Eih3/Projet-RAGT-2015/Documents/PCB/Images/BDE54ddd67690729_03.jpg

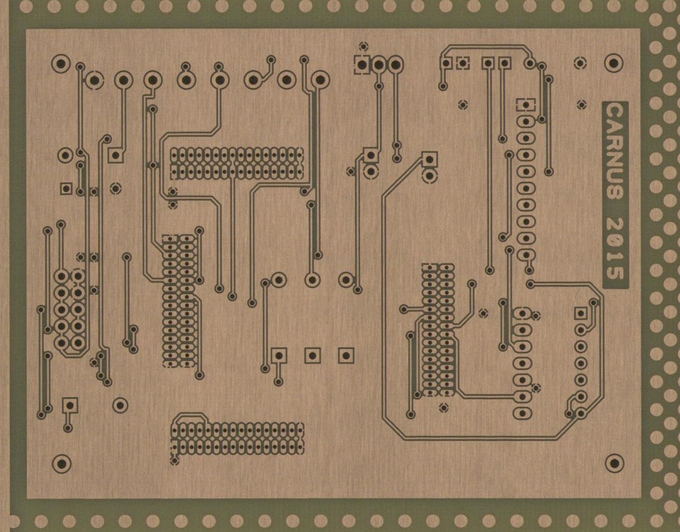
Documents/PCB/Images/BDE54ddd67690729_03.jpg
