Eih3/Projet-RAGT-2015/README.md

# Projet-RAGT-2015
Codes source de la programmation de la carte HF et de la Télécommande
