Eih3/Projet-RAGT-2015/Programmation/Module HF/Module HF.cydsn/CortexM3/ARM_GCC_484/Release/LINK_options.txt

-Wl,--start-group -o ".\\CortexM3\\ARM_GCC_484\\Release\\Module\ HF.elf" ".\\CortexM3\\ARM_GCC_484\\Release\\main.o" ".\\CortexM3\\ARM_GCC_484\\Release\\EEPROM.o" ".\\CortexM3\\ARM_GCC_484\\Release\\Application.o" ".\\CortexM3\\ARM_GCC_484\\Release\\WIFI.o" ".\\CortexM3\\ARM_GCC_484\\Release\\Interruptions.o" ".\\CortexM3\\ARM_GCC_484\\Release\\cymetadata.o" ".\\CortexM3\\ARM_GCC_484\\Release\\Cm3Start.o" ".\\CortexM3\\ARM_GCC_484\\Release\\Module\ HF.a" "C:\\Program\ Files\ (x86)\\Cypress\\PSoC\ Creator\\3.1\\PSoC\ Creator\\psoc\\content\\cycomponentlibrary\\CyComponentLibrary.cylib\\CortexM3\\ARM_GCC_484\\Release\\CyComponentLibrary.a" -mthumb -march=armv7-m -mfix-cortex-m3-ldrd "-Wl,-Map,.\\CortexM3\\ARM_GCC_484\\Release/Module\ HF.map" -T ".\\Generated_Source\\PSoC5\\cm3gcc.ld" -g -specs=nano.specs "-u\ _printf_float"  -Wl,--gc-sections -Wl,--end-group
