Eih3/Projet-RAGT-2015/Documents/PCB/Carte Autom.png

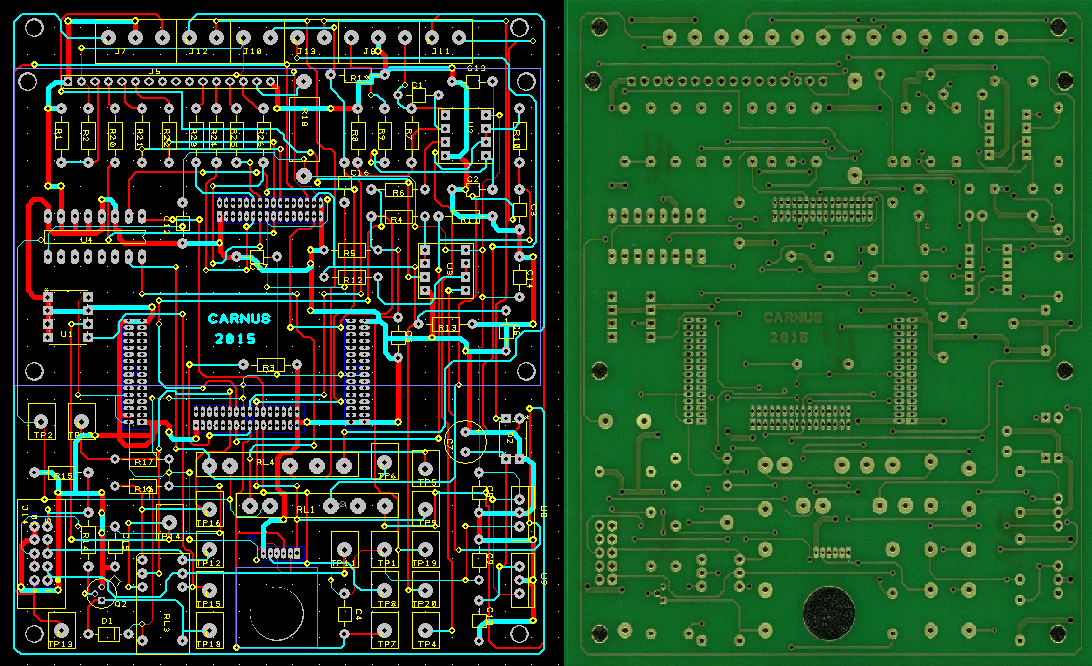
Documents/PCB/Carte Autom.png
