Eih3/Projet-RAGT-2015/Documents/PCB/Images/BDE54ddd677cd2a8_02.jpg

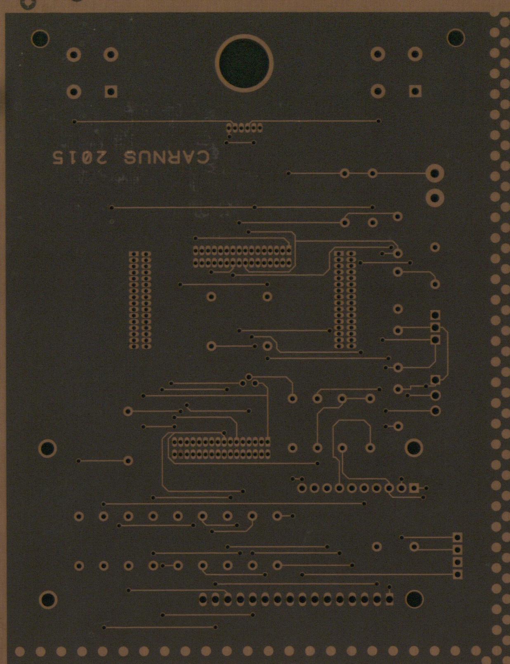
Documents/PCB/Images/BDE54ddd677cd2a8_02.jpg
