Eih3/Projet-RAGT-2015/Documents/PCB/Images/BDE54ddd677cd2a8_03_bottom.jpg

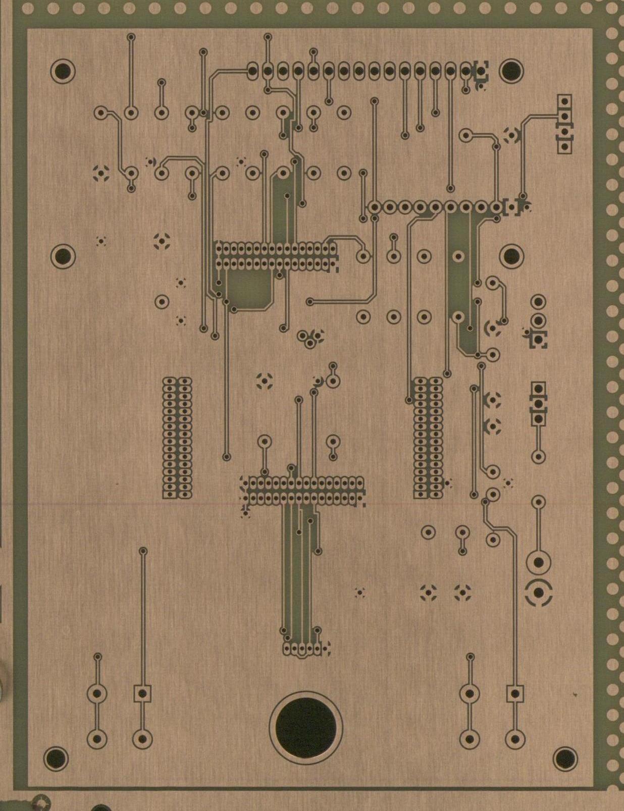
Documents/PCB/Images/BDE54ddd677cd2a8_03_bottom.jpg
