Eih3/Projet-RAGT-2015/Documents/PCB/Images/BDE54ddd6755764d_02.jpg

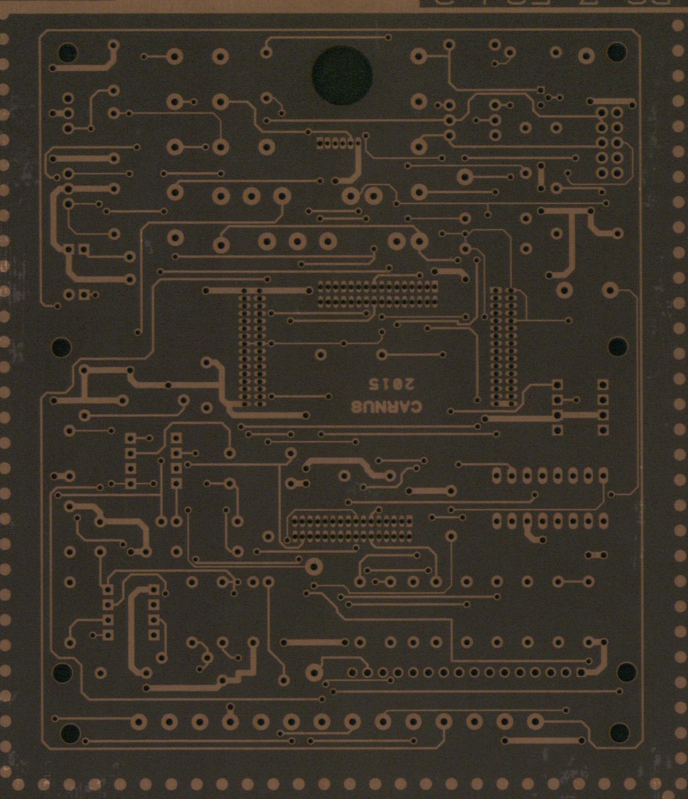
Documents/PCB/Images/BDE54ddd6755764d_02.jpg
