Eih3/Projet-RAGT-2015/Documents/PCB/Images/BDE54ddd6755764d_02_bottom.jpg

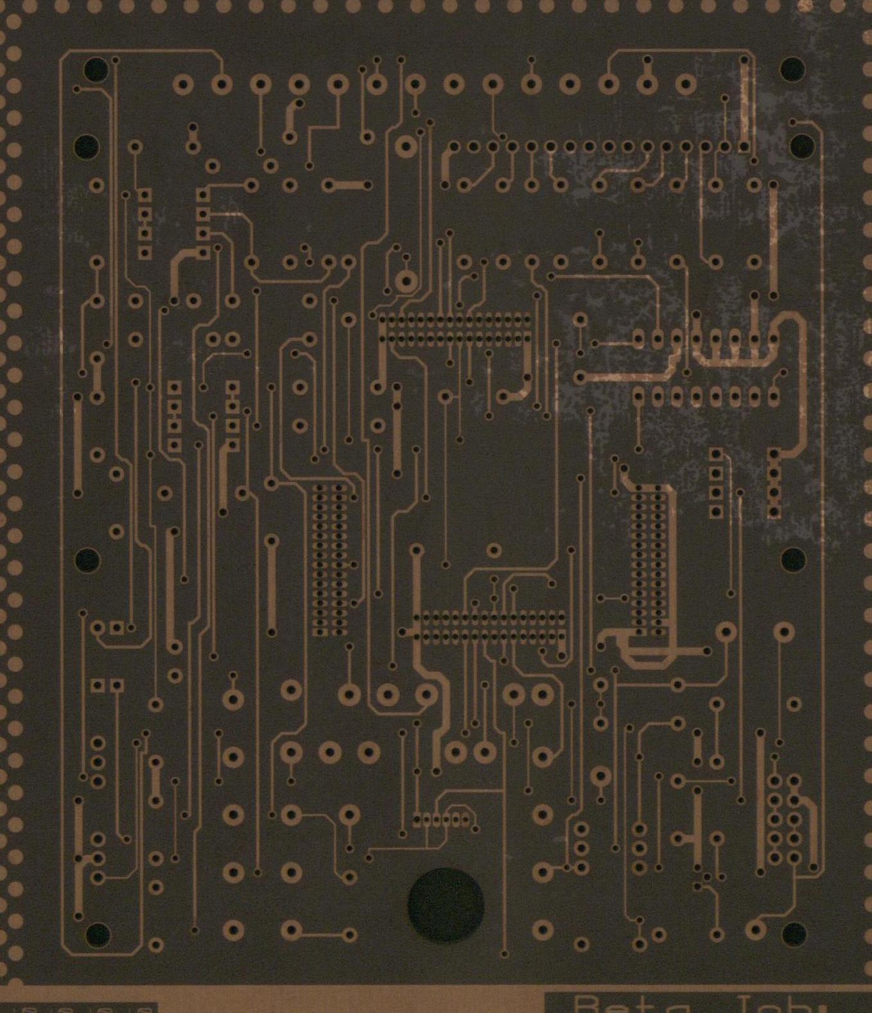
Documents/PCB/Images/BDE54ddd6755764d_02_bottom.jpg
