Eih3/Projet-RAGT-2015/Documents/PCB/Images/BDE54ddd67690729_04_seite1.jpg

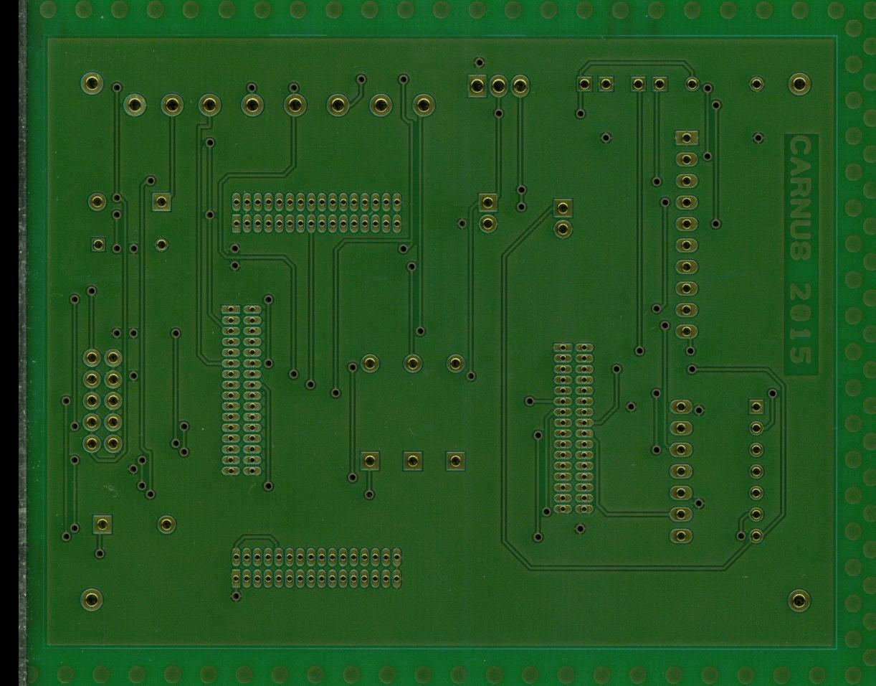
Documents/PCB/Images/BDE54ddd67690729_04_seite1.jpg
