Eih3/Projet-RAGT-2015/Documents/USR-WIFI232-T/5.JPG

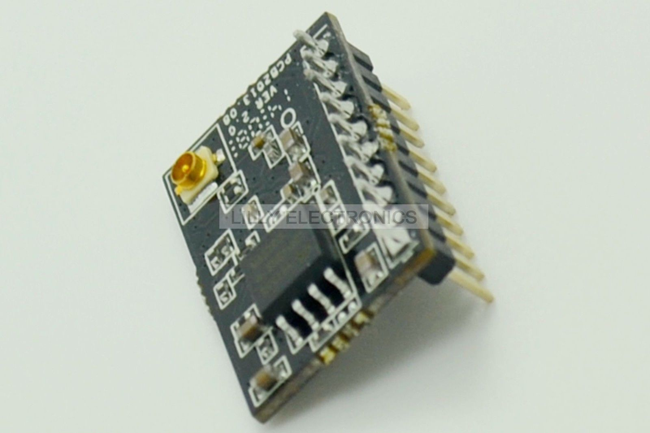
Documents/USR-WIFI232-T/5.JPG
