Eih3/Projet-RAGT-2015/Documents/USR-WIFI232-T/USR-WIFI232-T-size.png

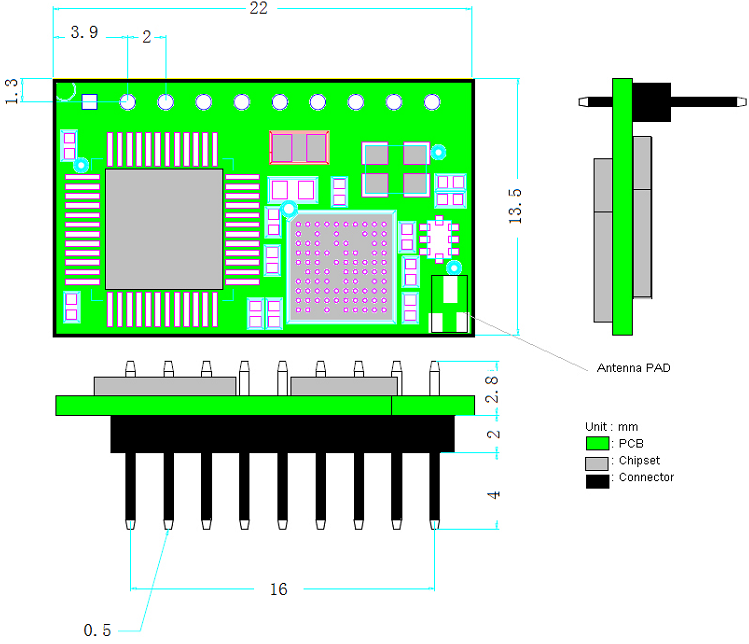
Documents/USR-WIFI232-T/USR-WIFI232-T-size.png
