Eih3/Projet-RAGT-2015/Programmation/Module HF/Module HF.cydsn/CortexM3/ARM_GCC_484/Debug/LINK_options.txt

-Wl,--start-group -o ".\\CortexM3\\ARM_GCC_484\\Debug\\Carte\ HF.elf" ".\\CortexM3\\ARM_GCC_484\\Debug\\main.o" ".\\CortexM3\\ARM_GCC_484\\Debug\\EEPROM.o" ".\\CortexM3\\ARM_GCC_484\\Debug\\module_hf.o" ".\\CortexM3\\ARM_GCC_484\\Debug\\cymetadata.o" ".\\CortexM3\\ARM_GCC_484\\Debug\\Cm3Start.o" ".\\CortexM3\\ARM_GCC_484\\Debug\\Carte\ HF.a" "C:\\Program\ Files\ (x86)\\Cypress\\PSoC\ Creator\\3.1\\PSoC\ Creator\\psoc\\content\\cycomponentlibrary\\CyComponentLibrary.cylib\\CortexM3\\ARM_GCC_484\\Debug\\CyComponentLibrary.a" -mthumb -march=armv7-m -mfix-cortex-m3-ldrd "-Wl,-Map,.\\CortexM3\\ARM_GCC_484\\Debug/Carte\ HF.map" -T ".\\Generated_Source\\PSoC5\\cm3gcc.ld" -g -specs=nano.specs "-u\ _printf_float"  -Wl,--gc-sections -Wl,--end-group
