Eih3/Projet-RAGT-2015/Documents/PSoC5/CY8CKIT-010_Schematic.pdf

Storage Capacitors | Bypass Capacitors

## CY8C55 FAMILY

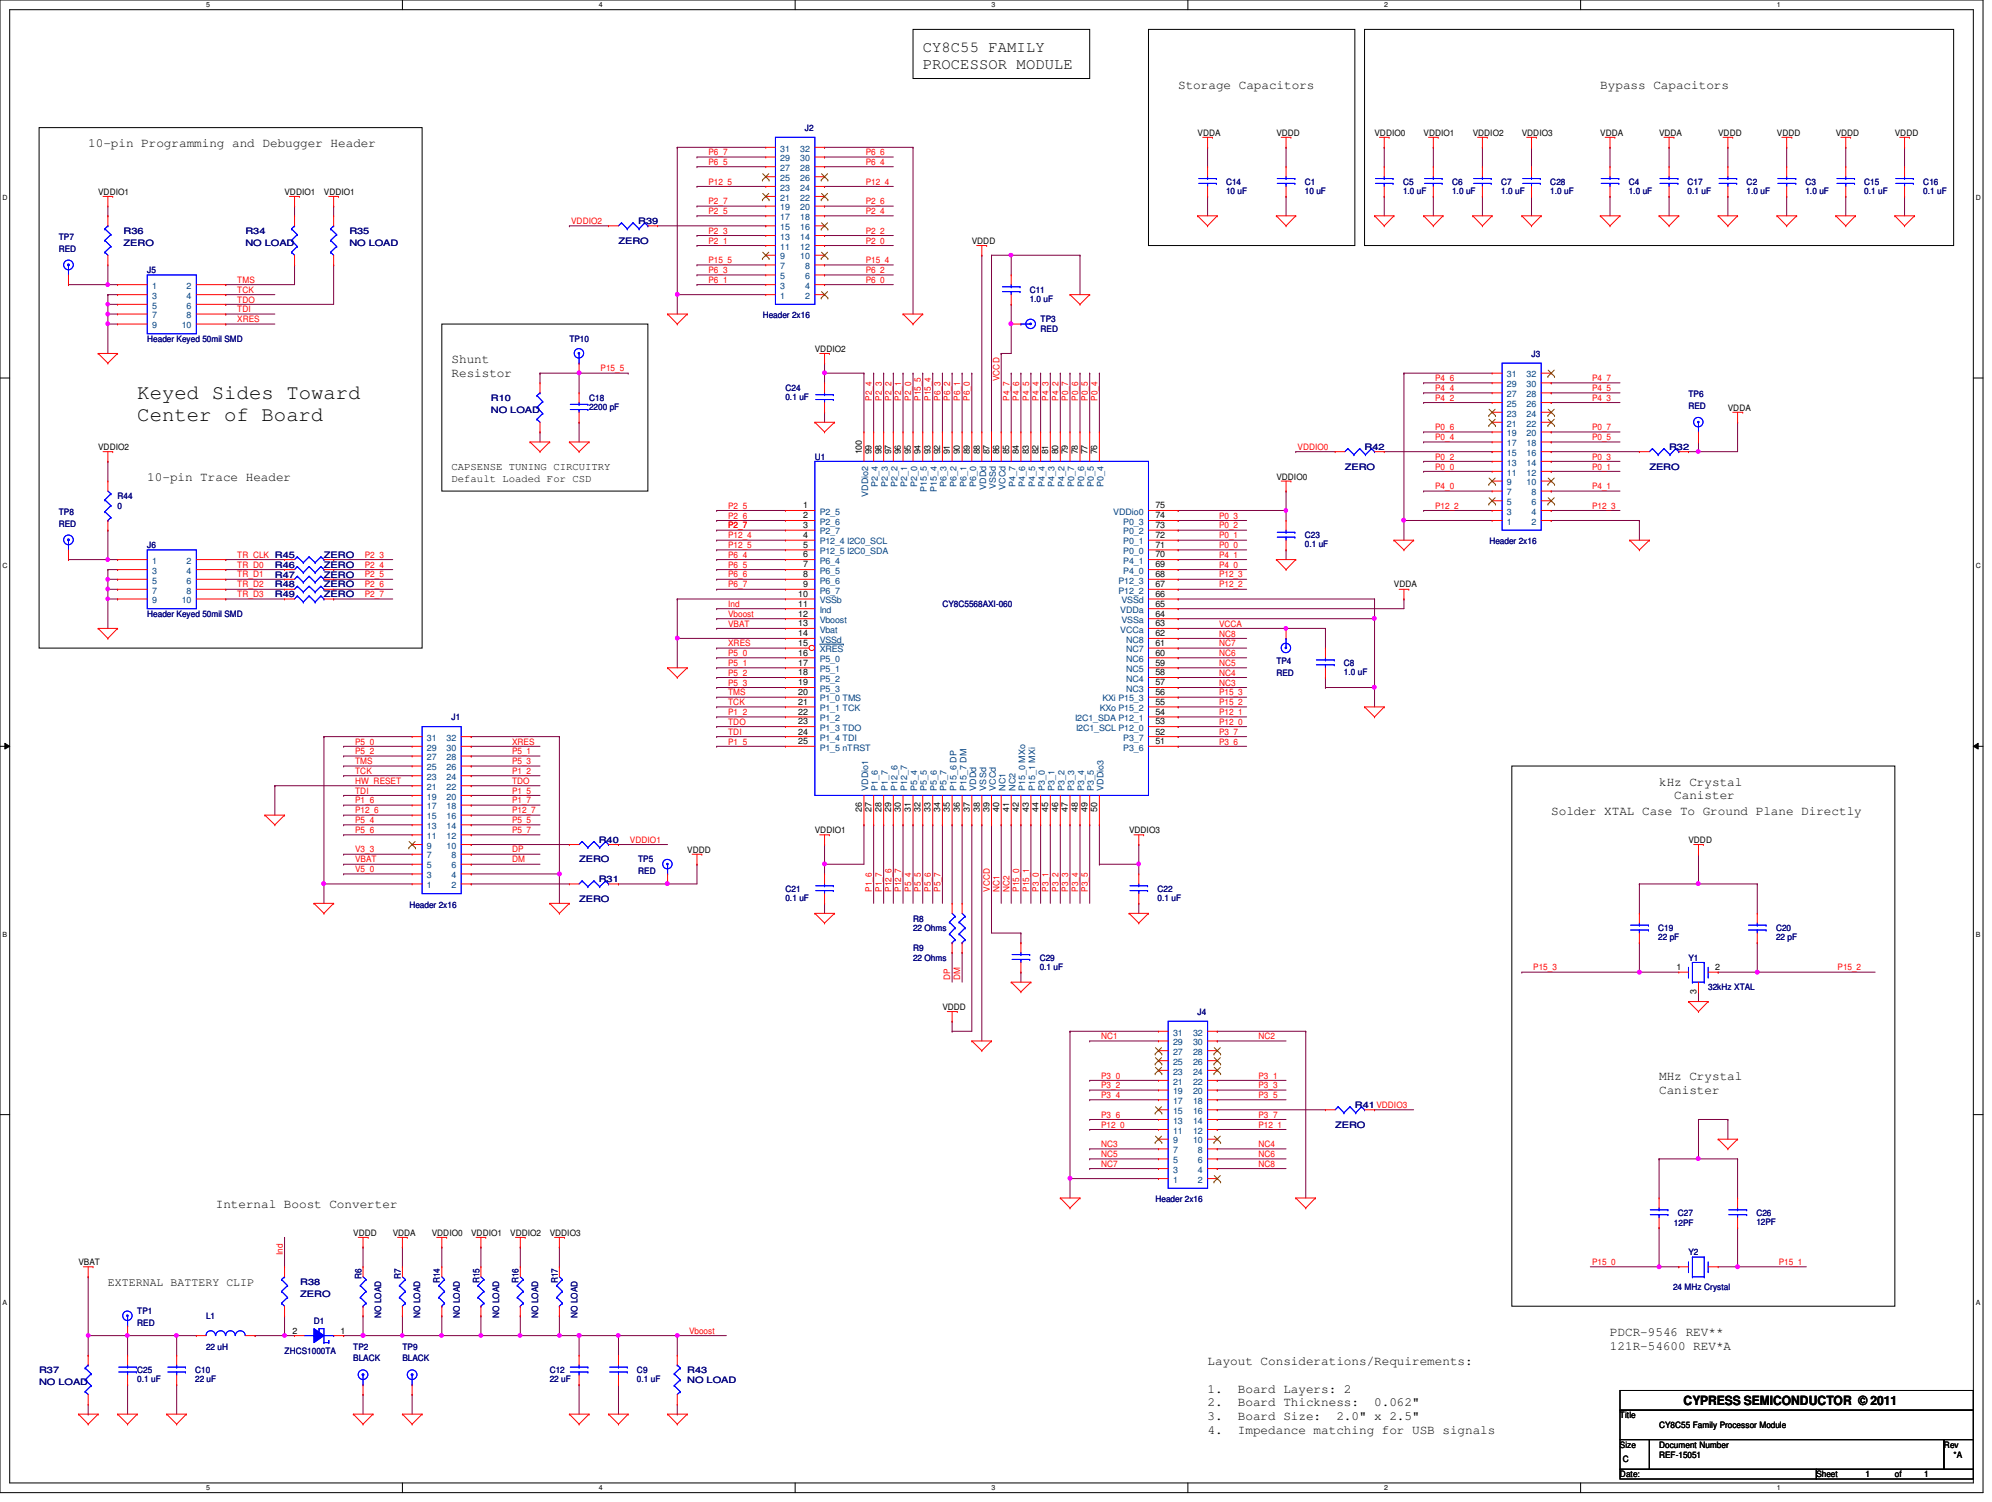
[picture p57: page 1]

10-pin Programming and Debugger Header

Solder XTAL Case To Ground Plane Directly

1. Board Layers: 2
4. Impedance matching for USB signals
