Eih3/Projet-RAGT-2015/Documents/PSoC5/PSOC Break out - Schematic.pdf

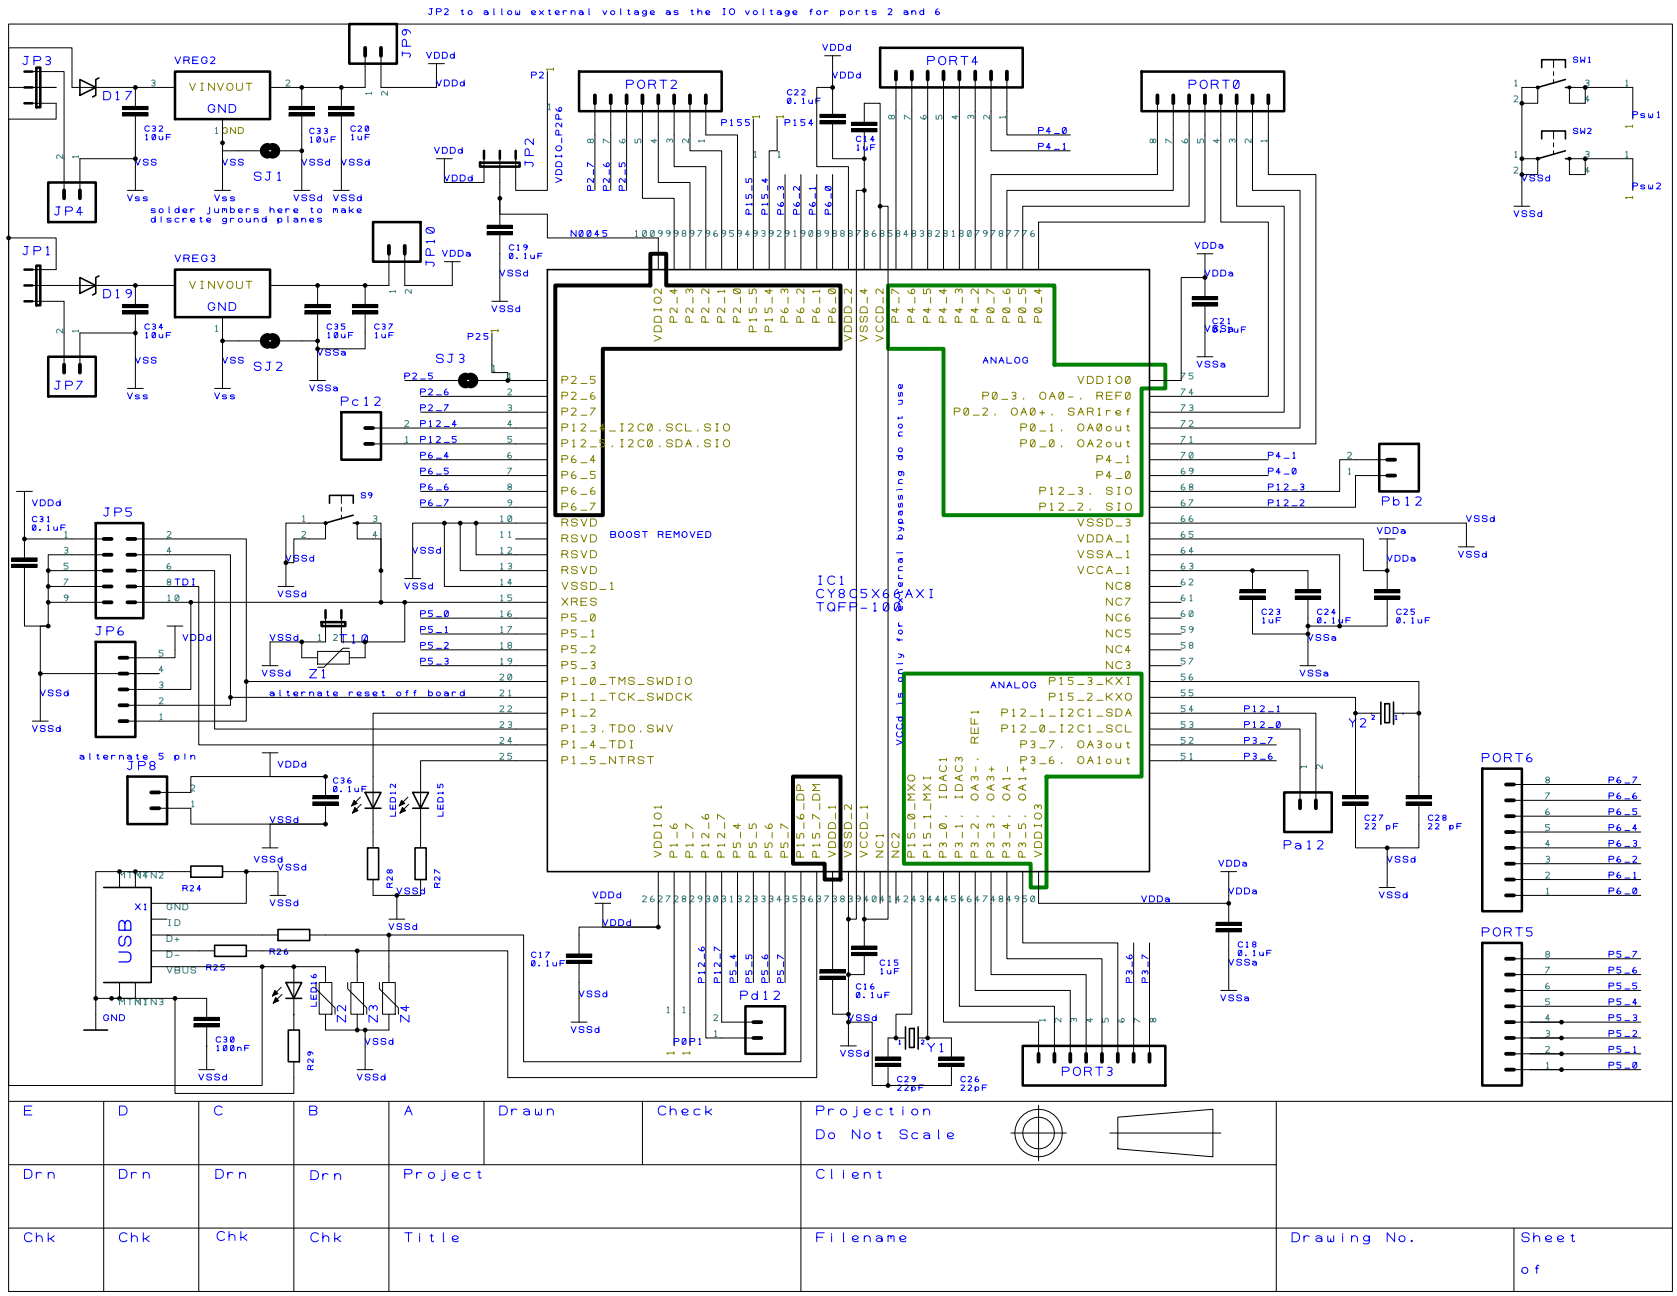
[picture p58: page 1]
