Eih3/Projet-RAGT-2015/(list of files, drawings)

Other design files:
Documents/DesignSpark/Afficheur.pcb
Documents/DesignSpark/PCB_autom.pcb
Documents/DesignSpark/Projet HF, Routage.pcb
Documents/PCB/Afficheur.pcb
Documents/PCB/HF.pcb
Documents/PCB/PCB_autom.pcb
