Eih3/Projet-RAGT-2015/Programmation/Module HF/Module HF.cydsn/codegentemp/UART_INT.c

/*******************************************************************************
* File Name: UARTINT.c
* Version 2.40
*
* Description:
*  This file provides all Interrupt Service functionality of the UART component
*
* Note:
*
********************************************************************************
* Copyright 2008-2015, Cypress Semiconductor Corporation.  All rights reserved.
* You may use this file only in accordance with the license, terms, conditions,
* disclaimers, and limitations in the end user license agreement accompanying
* the software package with which this file was provided.
*******************************************************************************/

#include "UART.h"


/***************************************
* Custom Declarations
***************************************/
/* `#START CUSTOM_DECLARATIONS` Place your declaration here */

/* `#END` */

#if (UART_RX_INTERRUPT_ENABLED && (UART_RX_ENABLED || UART_HD_ENABLED))
    /*******************************************************************************
    * Function Name: UART_RXISR
    ********************************************************************************
    *
    * Summary:
    *  Interrupt Service Routine for RX portion of the UART
    *
    * Parameters:
    *  None.
    *
    * Return:
    *  None.
    *
    * Global Variables:
    *  UART_rxBuffer - RAM buffer pointer for save received data.
    *  UART_rxBufferWrite - cyclic index for write to rxBuffer,
    *     increments after each byte saved to buffer.
    *  UART_rxBufferRead - cyclic index for read from rxBuffer,
    *     checked to detect overflow condition.
    *  UART_rxBufferOverflow - software overflow flag. Set to one
    *     when UART_rxBufferWrite index overtakes
    *     UART_rxBufferRead index.
    *  UART_rxBufferLoopDetect - additional variable to detect overflow.
    *     Set to one when UART_rxBufferWrite is equal to
    *    UART_rxBufferRead
    *  UART_rxAddressMode - this variable contains the Address mode,
    *     selected in customizer or set by UART_SetRxAddressMode() API.
    *  UART_rxAddressDetected - set to 1 when correct address received,
    *     and analysed to store following addressed data bytes to the buffer.
    *     When not correct address received, set to 0 to skip following data bytes.
    *
    *******************************************************************************/
    CY_ISR(UART_RXISR)
    {
        uint8 readData;
        uint8 increment_pointer = 0u;

    #if(CY_PSOC3)
        uint8 int_en;
    #endif /* (CY_PSOC3) */

        /* User code required at start of ISR */
        /* `#START UART_RXISR_START` */

        /* `#END` */

    #if(CY_PSOC3)   /* Make sure nested interrupt is enabled */
        int_en = EA;
        CyGlobalIntEnable;
    #endif /* (CY_PSOC3) */

        readData = UART_RXSTATUS_REG;

        if((readData & (UART_RX_STS_BREAK | UART_RX_STS_PAR_ERROR |
                        UART_RX_STS_STOP_ERROR | UART_RX_STS_OVERRUN)) != 0u)
        {
            /* ERROR handling. */
            UART_errorStatus = readData & ( UART_RX_STS_BREAK | 
                                                        UART_RX_STS_PAR_ERROR | 
                                                        UART_RX_STS_STOP_ERROR | 
                                                        UART_RX_STS_OVERRUN);
            /* `#START UART_RXISR_ERROR` */

            /* `#END` */
        }

        while((readData & UART_RX_STS_FIFO_NOTEMPTY) != 0u)
        {
        #if (UART_RXHW_ADDRESS_ENABLED)
            if(UART_rxAddressMode == (uint8)UART__B_UART__AM_SW_DETECT_TO_BUFFER)
            {
                if((readData & UART_RX_STS_MRKSPC) != 0u)
                {
                    if ((readData & UART_RX_STS_ADDR_MATCH) != 0u)
                    {
                        UART_rxAddressDetected = 1u;
                    }
                    else
                    {
                        UART_rxAddressDetected = 0u;
                    }
                }

                readData = UART_RXDATA_REG;
                if(UART_rxAddressDetected != 0u)
                {   /* Store only addressed data */
                    UART_rxBuffer[UART_rxBufferWrite] = readData;
                    increment_pointer = 1u;
                }
            }
            else /* Without software addressing */
            {
                UART_rxBuffer[UART_rxBufferWrite] = UART_RXDATA_REG;
                increment_pointer = 1u;
            }
        #else  /* Without addressing */
            UART_rxBuffer[UART_rxBufferWrite] = UART_RXDATA_REG;
            increment_pointer = 1u;
        #endif /* (UART_RXHW_ADDRESS_ENABLED) */

            /* Do not increment buffer pointer when skip not addressed data */
            if(increment_pointer != 0u)
            {
                if(UART_rxBufferLoopDetect != 0u)
                {   /* Set Software Buffer status Overflow */
                    UART_rxBufferOverflow = 1u;
                }
                /* Set next pointer. */
                UART_rxBufferWrite++;

                /* Check pointer for a loop condition */
                if(UART_rxBufferWrite >= UART_RX_BUFFER_SIZE)
                {
                    UART_rxBufferWrite = 0u;
                }

                /* Detect pre-overload condition and set flag */
                if(UART_rxBufferWrite == UART_rxBufferRead)
                {
                    UART_rxBufferLoopDetect = 1u;
                    /* When Hardware Flow Control selected */
                    #if (UART_FLOW_CONTROL != 0u)
                        /* Disable RX interrupt mask, it is enabled when user read data from the buffer using APIs */
                        UART_RXSTATUS_MASK_REG  &= (uint8)~UART_RX_STS_FIFO_NOTEMPTY;
                        CyIntClearPending(UART_RX_VECT_NUM);
                        break; /* Break the reading of the FIFO loop, leave the data there for generating RTS signal */
                    #endif /* (UART_FLOW_CONTROL != 0u) */
                }
            }

            /* Read status to decide whether read more bytes */
            readData = UART_RXSTATUS_REG;
        }

        /* User code required at end of ISR (Optional) */
        /* `#START UART_RXISR_END` */

        /* `#END` */

    #if(CY_PSOC3)
        EA = int_en;
    #endif /* (CY_PSOC3) */
    }

#endif /* (UART_RX_INTERRUPT_ENABLED && (UART_RX_ENABLED || UART_HD_ENABLED)) */


#if (UART_TX_INTERRUPT_ENABLED && UART_TX_ENABLED)
    /*******************************************************************************
    * Function Name: UART_TXISR
    ********************************************************************************
    *
    * Summary:
    * Interrupt Service Routine for the TX portion of the UART
    *
    * Parameters:
    *  None.
    *
    * Return:
    *  None.
    *
    * Global Variables:
    *  UART_txBuffer - RAM buffer pointer for transmit data from.
    *  UART_txBufferRead - cyclic index for read and transmit data
    *     from txBuffer, increments after each transmitted byte.
    *  UART_rxBufferWrite - cyclic index for write to txBuffer,
    *     checked to detect available for transmission bytes.
    *
    *******************************************************************************/
    CY_ISR(UART_TXISR)
    {
    #if(CY_PSOC3)
        uint8 int_en;
    #endif /* (CY_PSOC3) */

        /* User code required at start of ISR */
        /* `#START UART_TXISR_START` */

        /* `#END` */

    #if(CY_PSOC3)   /* Make sure nested interrupt is enabled */
        int_en = EA;
        CyGlobalIntEnable;
    #endif /* (CY_PSOC3) */

        while((UART_txBufferRead != UART_txBufferWrite) &&
             ((UART_TXSTATUS_REG & UART_TX_STS_FIFO_FULL) == 0u))
        {
            /* Check pointer wrap around */
            if(UART_txBufferRead >= UART_TX_BUFFER_SIZE)
            {
                UART_txBufferRead = 0u;
            }

            UART_TXDATA_REG = UART_txBuffer[UART_txBufferRead];

            /* Set next pointer */
            UART_txBufferRead++;
        }

        /* User code required at end of ISR (Optional) */
        /* `#START UART_TXISR_END` */

        /* `#END` */

    #if(CY_PSOC3)
        EA = int_en;
    #endif /* (CY_PSOC3) */
    }

#endif /* (UART_TX_INTERRUPT_ENABLED && UART_TX_ENABLED) */


/* [] END OF FILE */
