Eih3/Projet-RAGT-2015/Programmation/Module HF/Module HF.cydsn/codegentemp/UART_PM.c

/*******************************************************************************
* File Name: UART_PM.c
* Version 2.40
*
* Description:
*  This file provides Sleep/WakeUp APIs functionality.
*
* Note:
*
********************************************************************************
* Copyright 2008-2015, Cypress Semiconductor Corporation.  All rights reserved.
* You may use this file only in accordance with the license, terms, conditions,
* disclaimers, and limitations in the end user license agreement accompanying
* the software package with which this file was provided.
*******************************************************************************/

#include "UART.h"


/***************************************
* Local data allocation
***************************************/

static UART_BACKUP_STRUCT  UART_backup =
{
    /* enableState - disabled */
    0u,
};



/*******************************************************************************
* Function Name: UART_SaveConfig
********************************************************************************
*
* Summary:
*  This function saves the component configuration and nonretention registers.
*  It also saves the current component parameter values, as defined in the
*  Configure dialog or as modified by appropriate APIs. This function is called
*  by the UART_Sleep() function.
*
* Parameters:
*  None.
*
* Return:
*  None.
*
* Global Variables:
*  UART_backup - modified when non-retention registers are saved.
*
* Reentrant:
*  No.
*
* Side Effects:
*  All nonretention registers except FIFO are saved to RAM
*
*******************************************************************************/
void UART_SaveConfig(void)
{
    #if(UART_CONTROL_REG_REMOVED == 0u)
        UART_backup.cr = UART_CONTROL_REG;
    #endif /* End UART_CONTROL_REG_REMOVED */
}


/*******************************************************************************
* Function Name: UART_RestoreConfig
********************************************************************************
*
* Summary:
*  Restores the user configuration of nonretention registers.
*
* Parameters:
*  None.
*
* Return:
*  None.
*
* Global Variables:
*  UART_backup - used when non-retention registers are restored.
*
* Reentrant:
*  No.
*
* Side Effects:
*  All nonretention registers except FIFO loaded from RAM. This function should
*  be called only after UART_SaveConfig() is called, otherwise
*  incorrect data will be loaded into the registers.
*
*******************************************************************************/
void UART_RestoreConfig(void)
{
    #if(UART_CONTROL_REG_REMOVED == 0u)
        UART_CONTROL_REG = UART_backup.cr;
    #endif /* End UART_CONTROL_REG_REMOVED */
}


/*******************************************************************************
* Function Name: UART_Sleep
********************************************************************************
*
* Summary:
*  This is the preferred API to prepare the component for sleep. 
*  The UART_Sleep() API saves the current component state. Then it
*  calls the UART_Stop() function and calls 
*  UART_SaveConfig() to save the hardware configuration.
*  Call the UART_Sleep() function before calling the CyPmSleep() 
*  or the CyPmHibernate() function. 
*
* Parameters:
*  None.
*
* Return:
*  None.
*
* Global Variables:
*  UART_backup - modified when non-retention registers are saved.
*
* Reentrant:
*  No.
*
*******************************************************************************/
void UART_Sleep(void)
{
    #if(UART_RX_ENABLED || UART_HD_ENABLED)
        if((UART_RXSTATUS_ACTL_REG  & UART_INT_ENABLE) != 0u)
        {
            UART_backup.enableState = 1u;
        }
        else
        {
            UART_backup.enableState = 0u;
        }
    #else
        if((UART_TXSTATUS_ACTL_REG  & UART_INT_ENABLE) !=0u)
        {
            UART_backup.enableState = 1u;
        }
        else
        {
            UART_backup.enableState = 0u;
        }
    #endif /* End UART_RX_ENABLED || UART_HD_ENABLED*/

    UART_Stop();
    UART_SaveConfig();
}


/*******************************************************************************
* Function Name: UART_Wakeup
********************************************************************************
*
* Summary:
*  This is the preferred API to restore the component to the state when 
*  UART_Sleep() was called. The UART_Wakeup() function
*  calls the UART_RestoreConfig() function to restore the 
*  configuration. If the component was enabled before the 
*  UART_Sleep() function was called, the UART_Wakeup()
*  function will also re-enable the component.
*
* Parameters:
*  None.
*
* Return:
*  None.
*
* Global Variables:
*  UART_backup - used when non-retention registers are restored.
*
* Reentrant:
*  No.
*
*******************************************************************************/
void UART_Wakeup(void)
{
    UART_RestoreConfig();
    #if( (UART_RX_ENABLED) || (UART_HD_ENABLED) )
        UART_ClearRxBuffer();
    #endif /* End (UART_RX_ENABLED) || (UART_HD_ENABLED) */
    #if(UART_TX_ENABLED || UART_HD_ENABLED)
        UART_ClearTxBuffer();
    #endif /* End UART_TX_ENABLED || UART_HD_ENABLED */

    if(UART_backup.enableState != 0u)
    {
        UART_Enable();
    }
}


/* [] END OF FILE */
